roborecyclevip/2026_robo_recycle/3d models/independent_clamp_18mm_v2/generated/preview_DRAFT.png

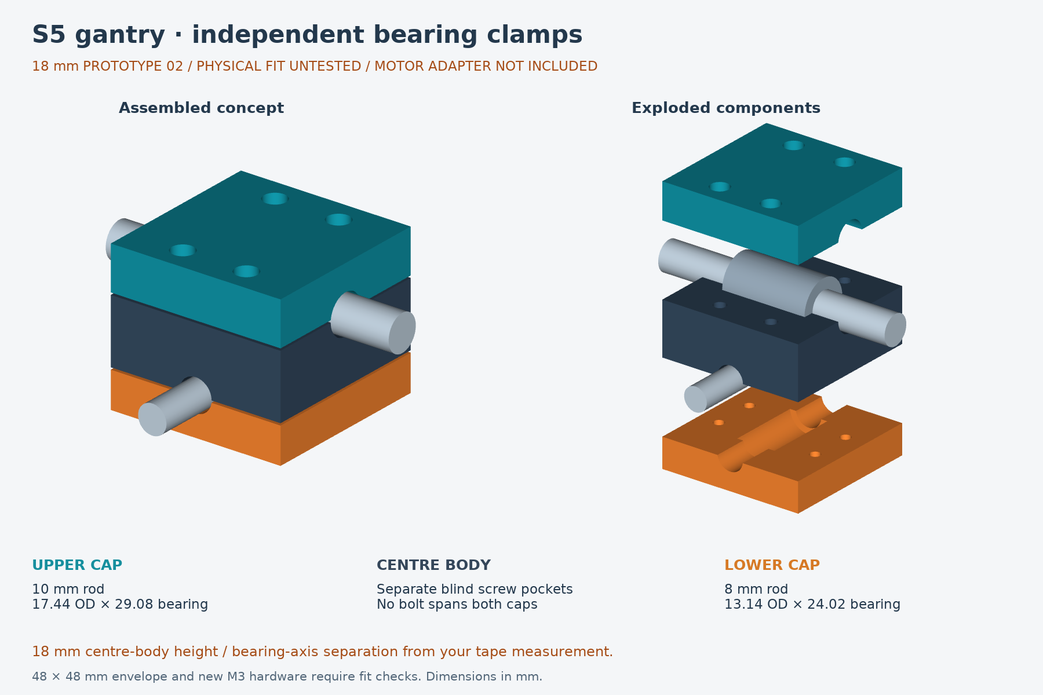
3d models/independent_clamp_18mm_v2/generated/preview_DRAFT.png
