roborecyclevip/2026_robo_recycle/docs/images/system_flowchart.png

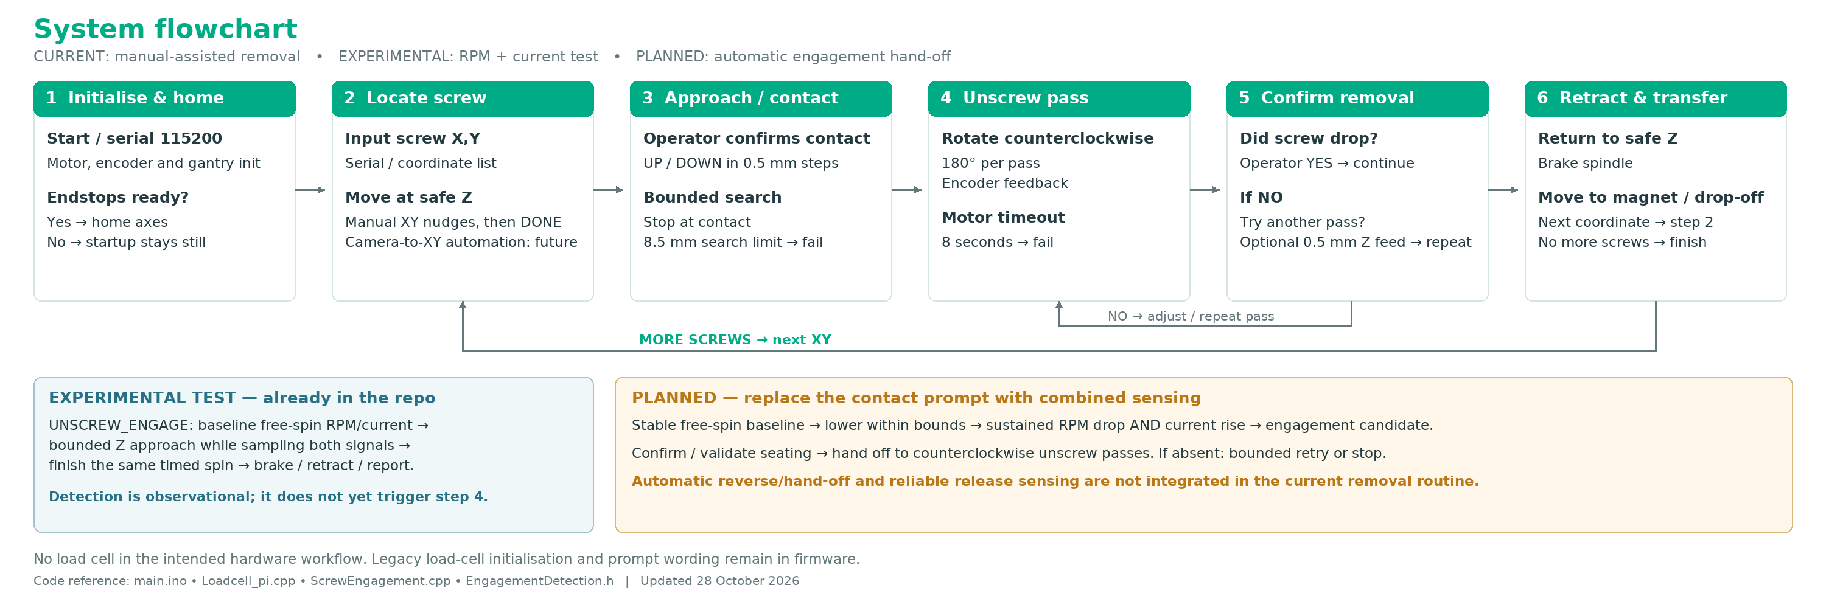
docs/images/system_flowchart.png
