roborecyclevip/2026_robo_recycle/saved_image.jpg

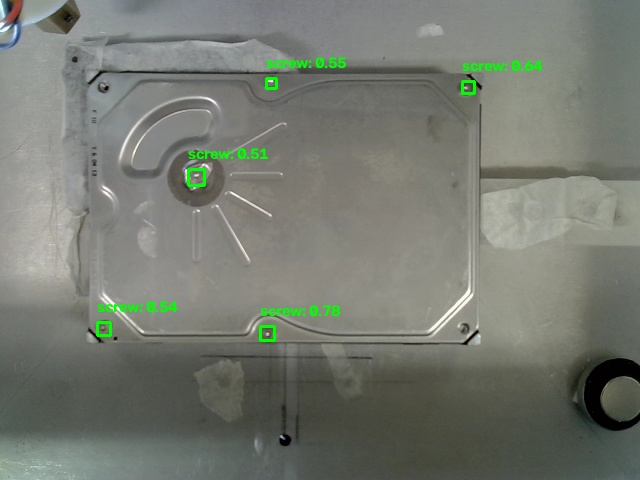
saved_image.jpg
