roborecyclevip/2026_robo_recycle/web_cam_7_oct_photos_of_hdd/my_photo-1.jpg

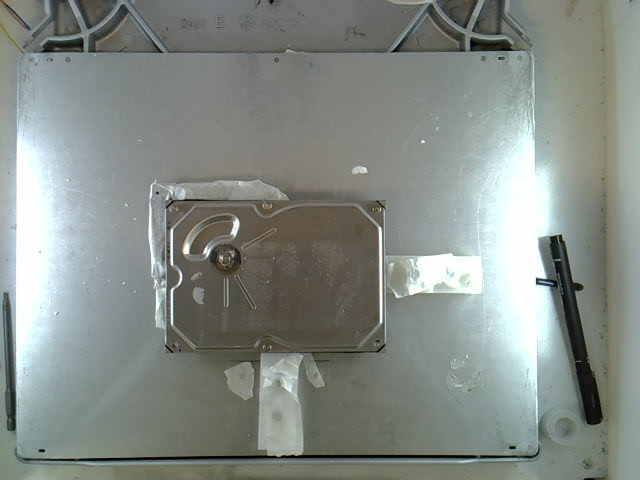
web_cam_7_oct_photos_of_hdd/my_photo-1.jpg
