roborecyclevip/2026_robo_recycle/3d models/independent_clamp_nut_v3/SHOPPING_LIST.md

# Bunnings Campbelltown — shopping list for v3

Checked 22 October 2026. These are Bunnings online listings, NOT confirmed stock at Campbelltown. Select Campbelltown on the product pages or phone before travelling. Prices can differ/change.

| Buy | Product / Bunnings item number | Listed price | Used in model |
|---|---|---:|---|
| 1 pack | [Pinnacle M3 × 15 mm zinc-plated round-head bolts and nuts, 20 pack](https://www.bunnings.com.au/pinnacle-m3-x-15mm-zinc-plated-round-head-bolts-and-nuts-20-pack_p0168388), **0168388** | $4.12 | Eight bolts: four top cap, four lower cap. Matching plain hex nuts are included. |
| 1 pack | [Pinnacle M3 × 20 mm zinc-plated round-head bolts and nuts, 18 pack](https://www.bunnings.com.au/pinnacle-m3-x-20mm-zinc-plated-round-head-bolts-and-nuts-18-pack_p0247264), **0247264** | $1.86 | Four motor-to-foot bolts and matching nuts. Length assumes an accessible 2–10 mm thick mounting flange, nominal 4 mm. |
| 2 packs | [Pinnacle M3 black flat washers, 12 pack](https://www.bunnings.com.au/pinnacle-m3-black-flat-washer-12-pack_p0257725), **0257725** | $1.53 each | Twelve used, twelve spare. Listing gives 3.5 mm hole and 7 mm OD. Put one under every bolt head. |

Listed hardware total: **$9.04**. Nuts are included: no separate nut pack, inserts, soldering iron or thread taps are needed. Check the contents on the packet before purchasing.

## Check in the shop

- M3 metric **0.5 mm pitch** machine bolts, not timber/self-tapping screws, not countersunk heads.
- Ordinary M3 hex nuts, nominal **5.5 mm across flats and 2.4 mm thick**. Do not substitute taller nyloc, flange or cap nuts: they will not fit these pockets. Exact Pinnacle nut envelope is not published on the linked listing; measure/check the purchased nuts with the included coupon before the main print.
- Washers must fit the 8.2 mm counterbores. The design calculation uses 0.5 mm thickness; 0.3–0.8 mm is the checked clamp-stack range. If the purchased washers are thicker, change the stack/recess before assembly rather than losing nut engagement.
- Obtain a small screwdriver/bit that snugly fits the actual supplied bolt heads. Do not assume the original S5 hex driver fits these round-head bolts.

## Useful extras, only if you do not already have them

- **150 mm digital or vernier caliper:** strongly useful for measuring the nut pockets, 18 mm middle section and actual mounting pattern; no brand/stock/price confirmed here.
- Small tweezers or needle-nose pliers to load nuts through the side slots.
- 3.5 mm drill bit for gently clearing printed M3 holes and, only after fit verification, enlarging existing *plastic* M2.5 clearance holes where adequate wall remains. Clamp the removed part; do not drill near installed bearings, rods, motor or wiring. Do not enlarge an original threaded metal hole on assumption.
- Fine file/deburring tool and normal eye protection for drilling/support removal.

Do not buy threadlocker or glue for the printed nut traps. Captive pockets prevent nut rotation during tightening but are not vibration-locking nuts. Inspect witness marks and preload during testing; this prototype is not approved for unattended drill operation.

## Store

[Bunnings Campbelltown](https://www.bunnings.com.au/stores/nsw/campbelltown): corner Blaxland Road and Farrow Road, Campbelltown NSW 2560; **02 4634 6400**. The live store page takes precedence over older listings for a different Campbelltown address. No order or reservation has been placed.
