roborecyclevip/2026_robo_recycle/3d models/independent_clamp_draft_v1/generated/housing_assembly_DRAFT.step

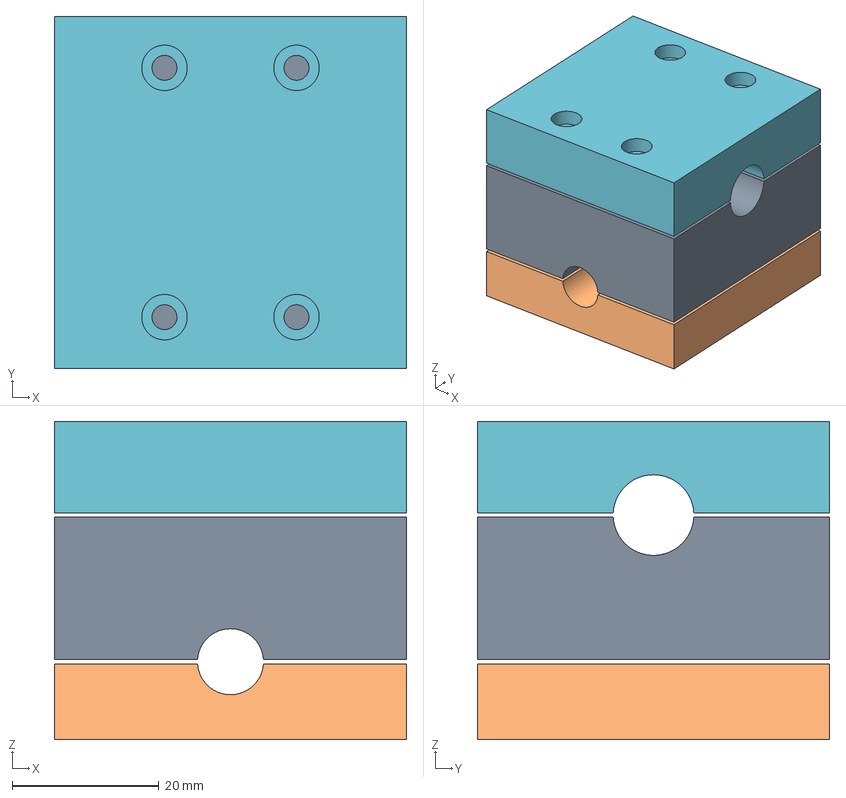
[picture p9: CAD file, 2026-10-22]
3d models/independent_clamp_draft_v1/generated/housing_assembly_DRAFT.step
48.0 x 48.0 x 43.4 mm
centre_body
upper_X_cap
lower_Y_cap
