roborecyclevip/2026_robo_recycle/3d models/independent_clamp_18mm_v2/generated/housing_assembly_DRAFT.step

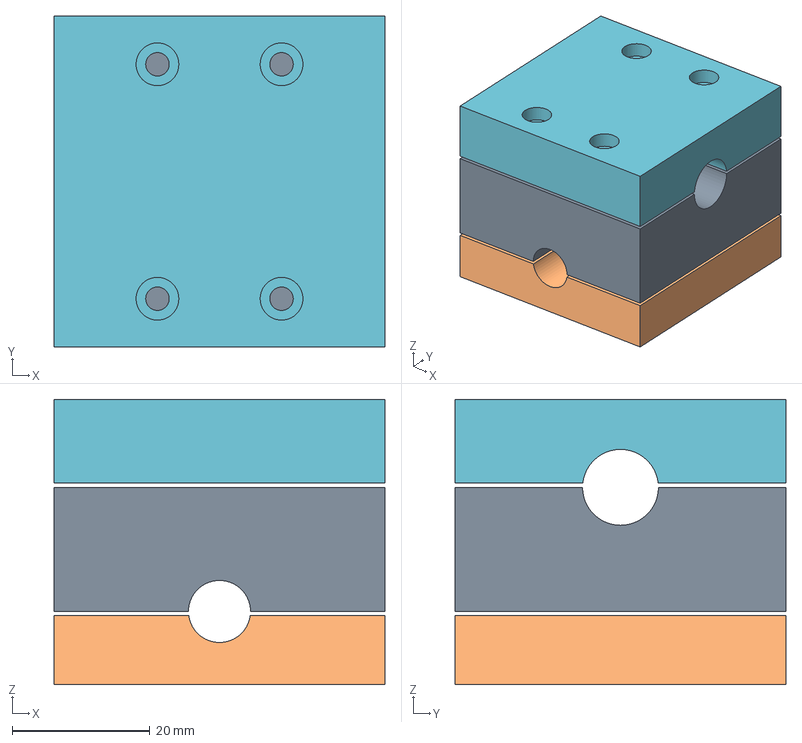
[picture p10: CAD file, 2026-10-22]
3d models/independent_clamp_18mm_v2/generated/housing_assembly_DRAFT.step
48.0 x 48.0 x 41.4 mm
centre_body
upper_X_cap
lower_Y_cap
