roborecyclevip/2026_robo_recycle/3d models/centre_body.stl

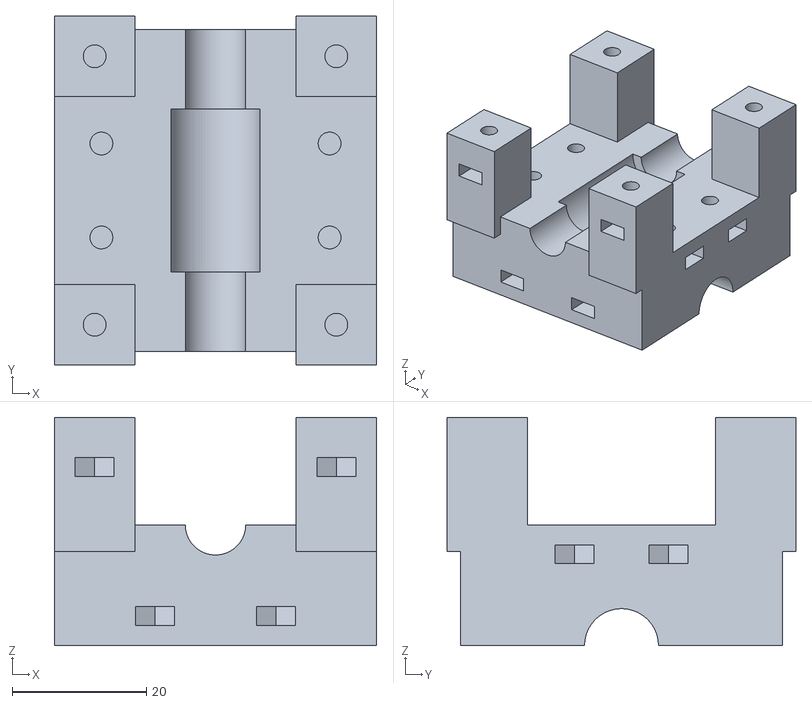
[picture p11: CAD file, 2026-10-22]
3d models/centre_body.stl
48.0 x 52.0 x 34.0
