roborecyclevip/2026_robo_recycle/3d models/independent_clamp_18mm_v2/generated/coupon_upper_plus0.10_DRAFT.stl

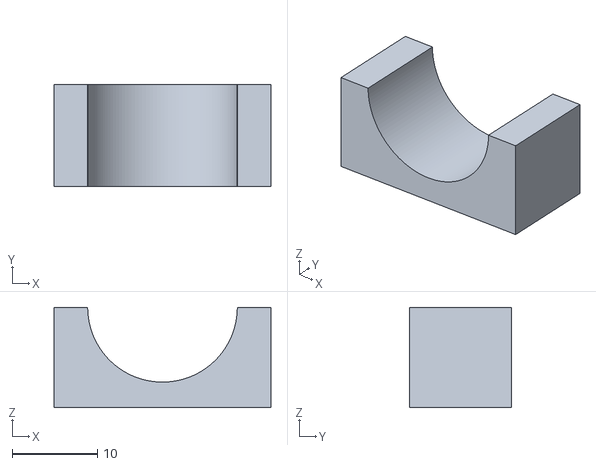
[picture p12: CAD file, 2026-10-22]
3d models/independent_clamp_18mm_v2/generated/coupon_upper_plus0.10_DRAFT.stl
25.4 x 12.0 x 11.8
