roborecyclevip/2026_robo_recycle/3d models/independent_clamp_draft_v1/generated/with_reference_rods_DRAFT.step

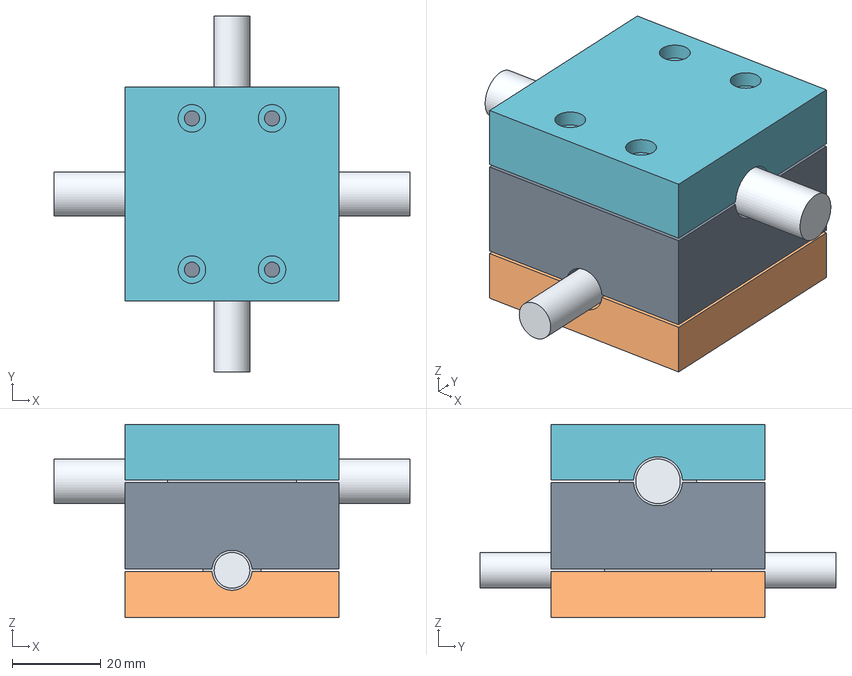
[picture p13: CAD file, 2026-10-22]
3d models/independent_clamp_draft_v1/generated/with_reference_rods_DRAFT.step
80.0 x 80.0 x 43.4 mm
centre_body
upper_X_cap
lower_Y_cap
upper_bearing_reference
lower_bearing_reference
upper_X_rod_reference
lower_Y_rod_reference
