roborecyclevip/2026_robo_recycle/3d models/independent_clamp_18mm_v2/generated/centre_body_DRAFT.step

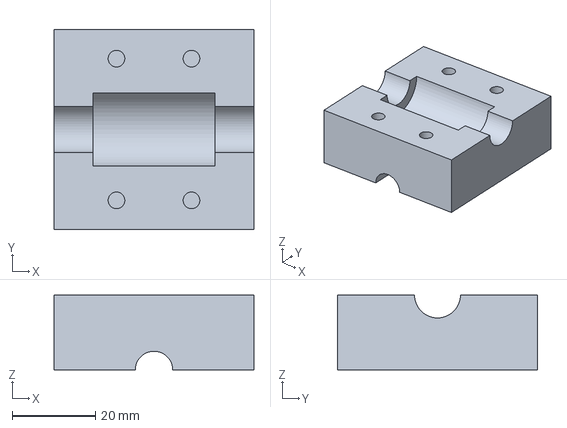
[picture p14: CAD file, 2026-10-22]
3d models/independent_clamp_18mm_v2/generated/centre_body_DRAFT.step
48.0 x 48.0 x 18.0 mm
