roborecyclevip/2026_robo_recycle/3d models/upper_cap.stl

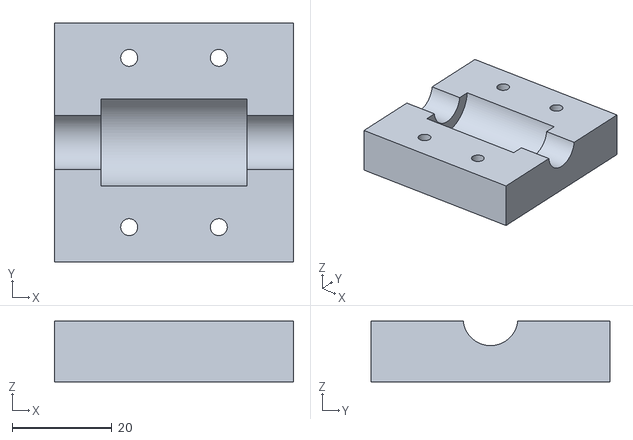
[picture p15: CAD file, 2026-10-22]
3d models/upper_cap.stl
48.0 x 48.0 x 12.2
