roborecyclevip/2026_robo_recycle/3d models/independent_clamp_18mm_v2/generated/with_reference_rods_DRAFT.step

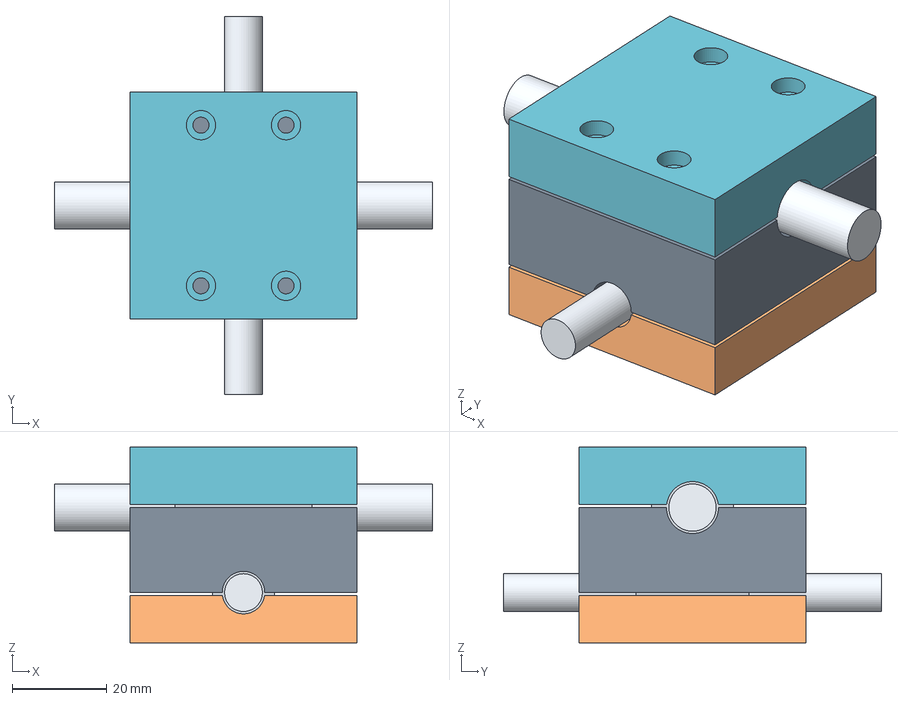
[picture p16: CAD file, 2026-10-22]
3d models/independent_clamp_18mm_v2/generated/with_reference_rods_DRAFT.step
80.0 x 80.0 x 41.4 mm
centre_body
upper_X_cap
lower_Y_cap
upper_bearing_reference
lower_bearing_reference
upper_X_rod_reference
lower_Y_rod_reference
