roborecyclevip/2026_robo_recycle/3d models/independent_clamp_draft_v1/generated/upper_X_cap_DRAFT.step

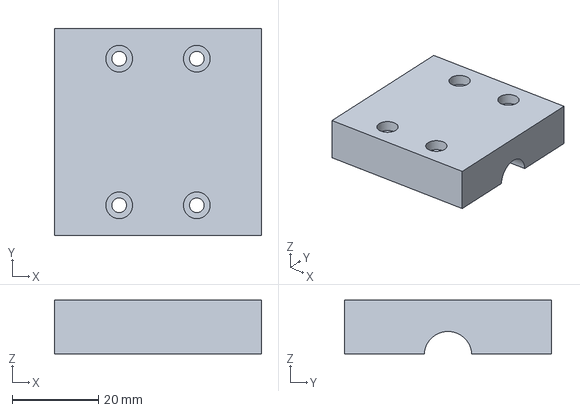
[picture p18: CAD file, 2026-10-22]
3d models/independent_clamp_draft_v1/generated/upper_X_cap_DRAFT.step
48.0 x 48.0 x 12.5 mm
