roborecyclevip/2026_robo_recycle/3d models/independent_clamp_18mm_v2/generated/upper_X_cap_DRAFT.step

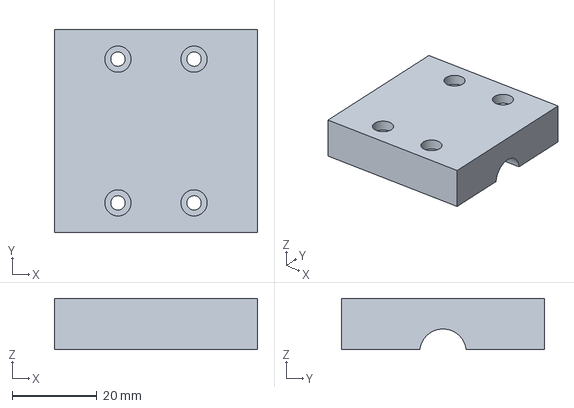
[picture p19: CAD file, 2026-10-22]
3d models/independent_clamp_18mm_v2/generated/upper_X_cap_DRAFT.step
48.0 x 48.0 x 12.2 mm
