roborecyclevip/2026_robo_recycle/3d models/independent_clamp_draft_v1/generated/lower_Y_cap_DRAFT.step

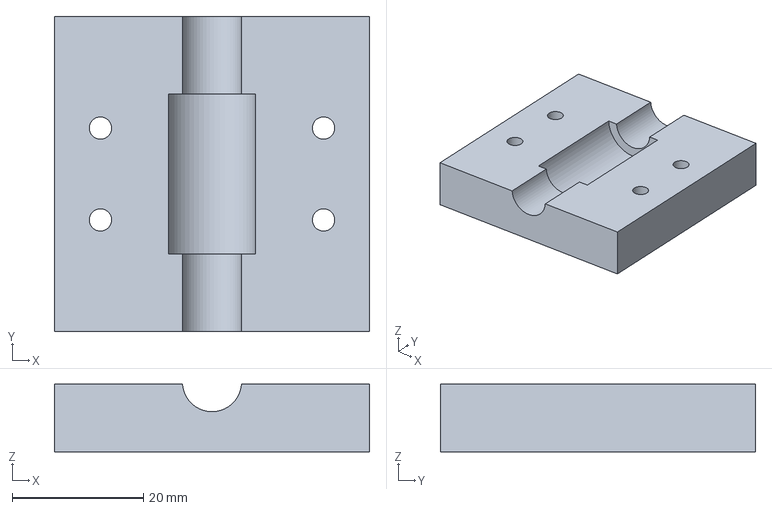
[picture p20: CAD file, 2026-10-22]
3d models/independent_clamp_draft_v1/generated/lower_Y_cap_DRAFT.step
48.0 x 48.0 x 10.3 mm
