roborecyclevip/2026_robo_recycle/3d models/independent_clamp_18mm_v2/generated/lower_Y_cap_DRAFT.step

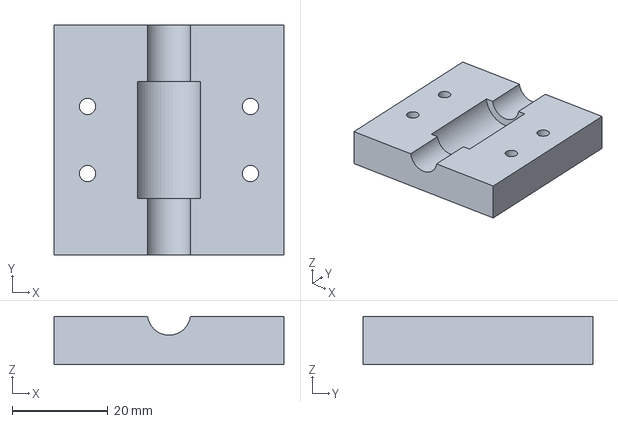
[picture p21: CAD file, 2026-10-22]
3d models/independent_clamp_18mm_v2/generated/lower_Y_cap_DRAFT.step
48.0 x 48.0 x 10.0 mm
