roborecyclevip/2026_robo_recycle/3d models/independent_clamp_draft_v1/generated/centre_body_DRAFT.step

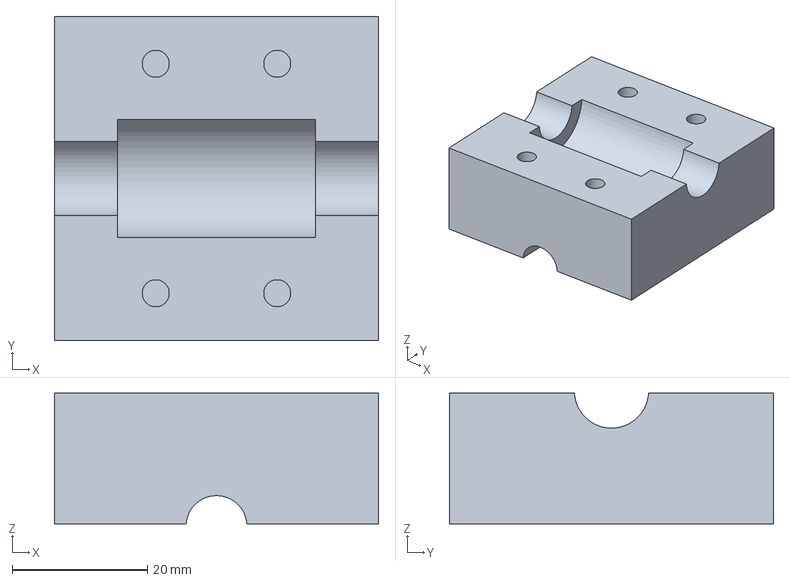
[picture p22: CAD file, 2026-10-22]
3d models/independent_clamp_draft_v1/generated/centre_body_DRAFT.step
48.0 x 48.0 x 19.4 mm
