roborecyclevip/2026_robo_recycle/3d models/independent_clamp_draft_v1/generated/coupon_lower_plus0.20_DRAFT.stl

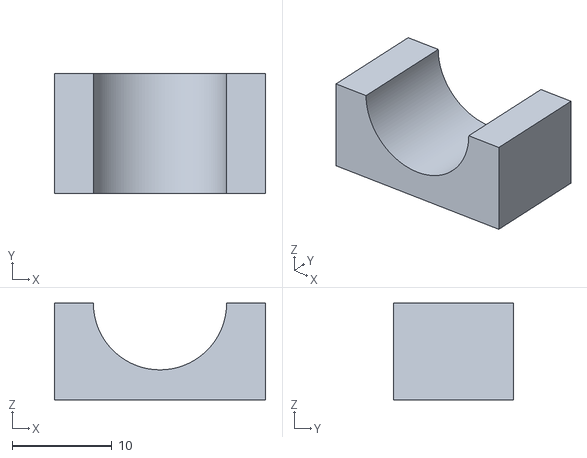
[picture p23: CAD file, 2026-10-22]
3d models/independent_clamp_draft_v1/generated/coupon_lower_plus0.20_DRAFT.stl
21.1 x 12.0 x 9.67
