roborecyclevip/2026_robo_recycle/3d models/independent_clamp_nut_v3/generated/housing_assembly_DRAFT.step

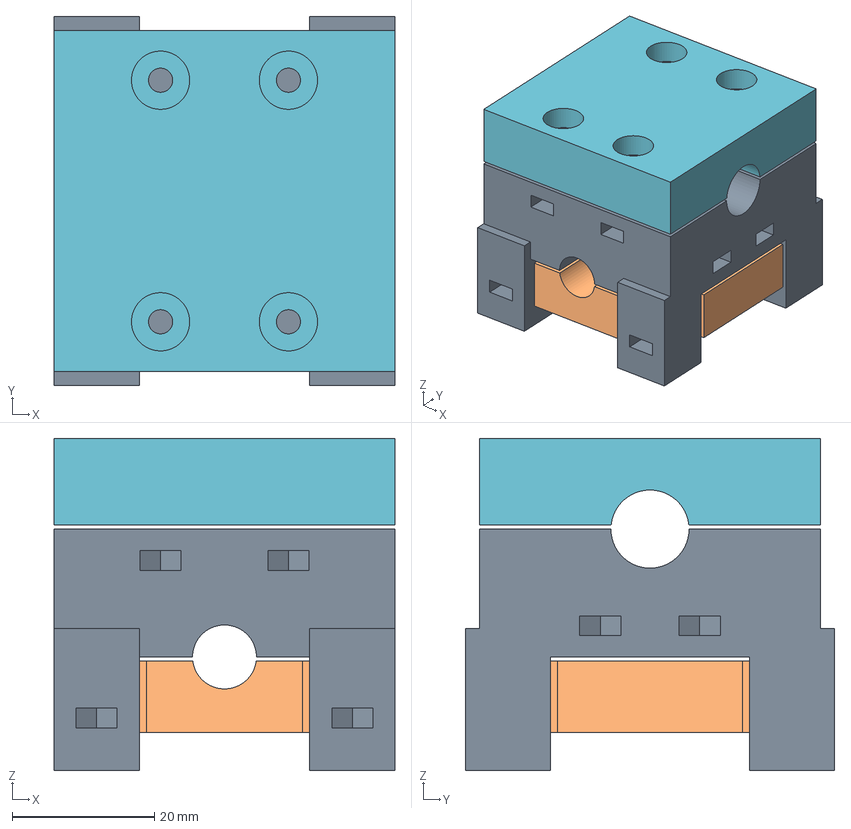
[picture p24: CAD file, 2026-10-22]
3d models/independent_clamp_nut_v3/generated/housing_assembly_DRAFT.step
48.0 x 52.0 x 46.8 mm
centre_body
upper_X_cap
lower_Y_cap
