roborecyclevip/2026_robo_recycle/3d models/independent_clamp_nut_v3/generated/M3_nut_fit_CHECK_FIRST.stl

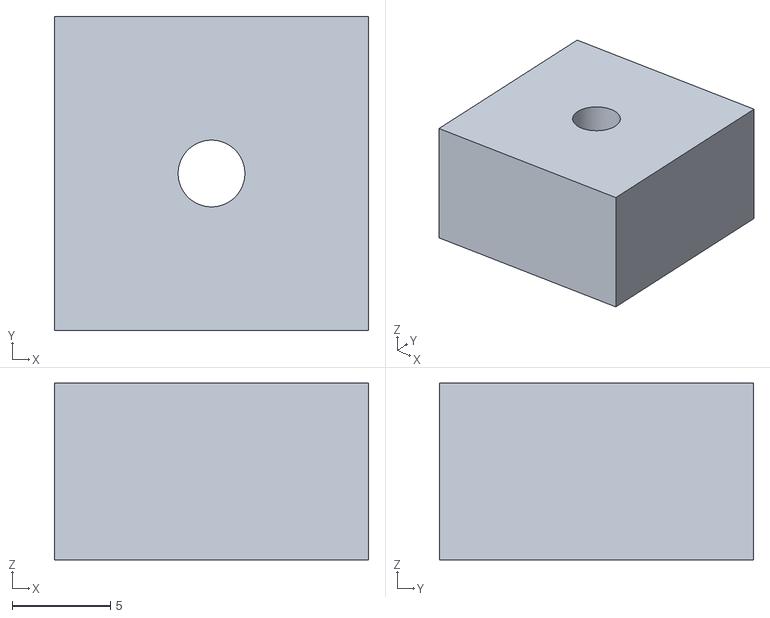
[picture p25: CAD file, 2026-10-22]
3d models/independent_clamp_nut_v3/generated/M3_nut_fit_CHECK_FIRST.stl
16.0 x 16.0 x 9.00
