roborecyclevip/2026_robo_recycle/(list of files, cad)

Other CAD files:
3d models/independent_clamp_nut_v3/generated/coupon_upper_plus0.20_DRAFT.stl
3d models/independent_clamp_18mm_v2/generated/centre_body_DRAFT.stl
3d models/independent_clamp_18mm_v2/generated/lower_Y_cap_DRAFT.stl
3d models/independent_clamp_18mm_v2/generated/upper_X_cap_DRAFT.stl
3d models/independent_clamp_draft_v1/generated/centre_body_DRAFT.stl
3d models/independent_clamp_draft_v1/generated/lower_Y_cap_DRAFT.stl
3d models/independent_clamp_draft_v1/generated/upper_X_cap_DRAFT.stl
3d models/independent_clamp_nut_v3/generated/centre_body_DRAFT.step
3d models/independent_clamp_nut_v3/generated/coupon_lower_plus0.10_DRAFT.stl
3d models/independent_clamp_nut_v3/generated/coupon_upper_plus0.00_DRAFT.stl
3d models/independent_clamp_nut_v3/generated/lower_Y_cap_DRAFT.step
3d models/independent_clamp_nut_v3/generated/lower_Y_cap_DRAFT.stl
3d models/independent_clamp_nut_v3/generated/motor_pattern_CHECK_FIRST.stl
3d models/independent_clamp_nut_v3/generated/upper_X_cap_DRAFT.step
3d models/independent_clamp_nut_v3/generated/with_reference_rods_DRAFT.step
