roborecyclevip/2026_robo_recycle/3d models/independent_clamp_18mm_v2/generated/assembled_scene.png

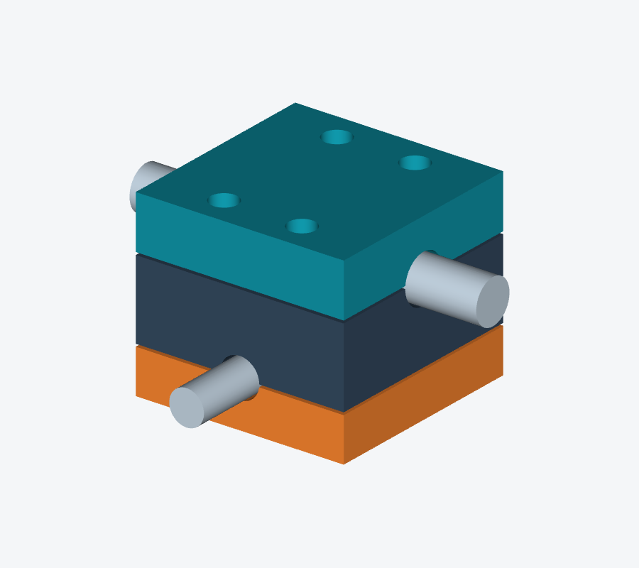
3d models/independent_clamp_18mm_v2/generated/assembled_scene.png
