roborecyclevip/2026_robo_recycle/Test files/with_harddrive.csv

with harddrive
cycle | phase | sample | current_A
1 | unscrewing | 1 | -0.073
1 | unscrewing | 2 | 0.220
1 | unscrewing | 3 | 0.464
1 | unscrewing | 4 | 0.073
1 | unscrewing | 5 | 0.269
1 | unscrewing | 6 | 0.269
1 | unscrewing | 7 | 0.562
1 | unscrewing | 8 | 0.367
1 | unscrewing | 9 | 0.415
1 | unscrewing | 10 | 0.318
1 | unscrewing | 11 | 0.220
1 | unscrewing | 12 | 0.464
1 | unscrewing | 13 | 0.415
1 | unscrewing | 14 | 0.122
1 | unscrewing | 15 | 0.318
1 | unscrewing | 16 | 0.318
1 | unscrewing | 17 | 0.318
1 | unscrewing | 18 | 0.415
1 | unscrewing | 19 | 0.367
1 | unscrewing | 20 | 0.318
1 | unscrewing | 21 | 0.269
1 | unscrewing | 22 | 0.220
1 | unscrewing | 23 | 0.415
1 | unscrewing | 24 | 0.318
1 | unscrewing | 25 | 0.367
1 | unscrewing | 26 | 0.269
1 | unscrewing | 27 | 0.415
1 | unscrewing | 28 | 0.122
1 | unscrewing | 29 | 0.269
1 | unscrewing | 30 | 0.269
1 | unscrewing | 31 | 0.367
1 | unscrewing | 32 | 0.415
1 | unscrewing | 33 | 0.269
1 | unscrewing | 34 | 0.318
1 | unscrewing | 35 | 0.415
1 | unscrewing | 36 | 0.367
1 | unscrewing | 37 | 0.367
1 | unscrewing | 38 | 0.318
1 | unscrewing | 39 | 0.220
1 | unscrewing | 40 | 0.367
1 | unscrewing | 41 | 0.269
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
