roborecyclevip/2026_robo_recycle/System Integration/main/STEPPERmotor.cpp

#include <Stepper.h>
#include <math.h>

#ifndef STEPPERMOTOR_H
#define STEPPERMOTOR_H

#include "MultiStepperLite.h"

// === CONFIG ===
#define STEPS_PER_MM_XY 143.8848920863309352517985612 // 10000 steps / 69.5 <-- Used Python decimal library to calc
#define STEPS_PER_MM_Z 398.7240829346092503987240829     // 10000 steps / 25.08 mm <-- ''

// === X AXIS ===
#define X_STEP_PIN 2
#define X_DIR_PIN 5
#define X_ENDSTOP_PIN 9
#define X_MOTOR_INDEX 0

// === Y AXIS ===
#define Y_STEP_PIN 3
#define Y_DIR_PIN 6
#define Y_ENDSTOP_PIN 10
#define Y_MOTOR_INDEX 1

// === Z AXIS ===
#define Z_STEP_PIN 4
#define Z_DIR_PIN 7
#define Z_ENDSTOP_PIN 11
#define Z_MOTOR_INDEX 2

// Step intervals in microseconds (derived from max speed)
#define STEP_INTERVAL_XY 10    // 100,000 steps/s = 10 µs/step
#define STEP_INTERVAL_Z 33     // 30,000 steps/s ≈ 33 µs/step
#define HOMING_STEP_INTERVAL 5000  // 200 steps/s = 5,000 µs/step
#define HOMING_TIMEOUT_MS 20000

// Global stepper instance and position variables
MultiStepperLite steppers(3); // Initialize with 3 motors (X, Y, Z)
float currentX = 0.0; // Current position in mm
float currentY = 0.0;
float currentZ = 0.0;
bool cooperativeZActive = false;
long cooperativeZSteps = 0;
float cooperativeZStart = 0.0;
int cooperativeZDirection = 1;

void setDirection(int dirPin, bool forward) {
  digitalWrite(dirPin, forward ? HIGH : LOW);
}

// homeAxis
void homeAxis(uint8_t motorIndex, int dirPin, int endstopPin, const char* axisName, bool reverse) {
  Serial.print("Homing ");
  Serial.println(axisName);

  int initialState = digitalRead(endstopPin);
  Serial.print(axisName);
  Serial.print(" endstop initial state: ");
  Serial.println(initialState == HIGH ? "HIGH" : "LOW");

  if (digitalRead(endstopPin) == LOW) {
    return;
  }

  pinMode(dirPin, OUTPUT);
  setDirection(dirPin, reverse ? true : false); // Z homes in positive direction, X/Y negative
  steppers.start_continuous(motorIndex, 200);

  unsigned long startMs = millis();
  while (digitalRead(endstopPin) != LOW) {
    steppers.do_tasks();

    if (millis() - startMs > HOMING_TIMEOUT_MS) {
      steppers.stop(motorIndex);
      while (!steppers.is_finished(motorIndex)) {
        steppers.do_tasks();
      }

      Serial.print("ERROR: ");
      Serial.print(axisName);
      Serial.println(" homing timeout. Check endstop state/direction.");
      return;
    }
  }

  steppers.stop(motorIndex);
  while (!steppers.is_finished(motorIndex)) {
    steppers.do_tasks(); // Ensure graceful stop (step pin LOW)
  }

  // Reset position to 0
  if (motorIndex == X_MOTOR_INDEX) currentX = 0.0;
  if (motorIndex == Y_MOTOR_INDEX) currentY = 0.0;
  if (motorIndex == Z_MOTOR_INDEX) currentZ = 0.0;

  Serial.print("Homed ");
  Serial.println(axisName);
}

void STEPPERmotor_Init() {
  // Initialize endstop pins
  pinMode(X_ENDSTOP_PIN, INPUT_PULLUP);
  pinMode(Y_ENDSTOP_PIN, INPUT_PULLUP);
  pinMode(Z_ENDSTOP_PIN, INPUT_PULLUP);

  // Initialize steppers
  steppers.init_stepper(X_MOTOR_INDEX, X_STEP_PIN);
  steppers.init_stepper(Y_MOTOR_INDEX, Y_STEP_PIN);
  steppers.init_stepper(Z_MOTOR_INDEX, Z_STEP_PIN);

  // Set step intervals
  steppers.set_step_interval(X_MOTOR_INDEX, STEP_INTERVAL_XY);
  steppers.set_step_interval(Y_MOTOR_INDEX, STEP_INTERVAL_XY);
  steppers.set_step_interval(Z_MOTOR_INDEX, STEP_INTERVAL_Z);

  // Initialize direction pins
  pinMode(X_DIR_PIN, OUTPUT);
  pinMode(Y_DIR_PIN, OUTPUT);
  pinMode(Z_DIR_PIN, OUTPUT);

  // Enable time autocorrect
#if TIME_AUTOCORRECT_SUPPORT
  steppers.set_autocorrect(true);
  steppers.set_min_step_interval(X_MOTOR_INDEX, STEP_INTERVAL_XY);
  steppers.set_min_step_interval(Y_MOTOR_INDEX, STEP_INTERVAL_XY);
  steppers.set_min_step_interval(Z_MOTOR_INDEX, STEP_INTERVAL_Z);
#endif

  // Initialize positions
  currentX = 0.0;
  currentY = 0.0;
  currentZ = 0.0;
}

bool Stepper_EndstopsReady() {
  // INPUT_PULLUP means a released switch should read HIGH and a pressed
  // (or shorted) switch should read LOW.
  const int xState = digitalRead(X_ENDSTOP_PIN);
  const int yState = digitalRead(Y_ENDSTOP_PIN);
  const int zState = digitalRead(Z_ENDSTOP_PIN);

  Serial.println("Initial end-stop check:");
  Serial.print("  X: ");
  Serial.println(xState == HIGH ? "RELEASED" : "PRESSED");
  Serial.print("  Y: ");
  Serial.println(yState == HIGH ? "RELEASED" : "PRESSED");
  Serial.print("  Z: ");
  Serial.println(zState == HIGH ? "RELEASED" : "PRESSED");

  // Bare-minimum startup guard: do not start homing if any switch is
  // already active. This avoids moving when a switch is stuck or shorted.
  return xState == HIGH && yState == HIGH && zState == HIGH;
}

void Stepper_HomeX() {
  homeAxis(X_MOTOR_INDEX, X_DIR_PIN, X_ENDSTOP_PIN, "X", false);
}

void Stepper_HomeY() {
  homeAxis(Y_MOTOR_INDEX, Y_DIR_PIN, Y_ENDSTOP_PIN, "Y", false);
}

void Stepper_HomeZ() {
  homeAxis(Z_MOTOR_INDEX, Z_DIR_PIN, Z_ENDSTOP_PIN, "Z", true);
}

void Stepper_HomeAll() {
  Stepper_HomeZ();
  Stepper_HomeX();
  Stepper_HomeY();
}

void Stepper_MoveTo(float x_mm, float y_mm, float z_mm) {
  // Convert coordinates to steps
  long x_steps = (long)((x_mm - currentX) * STEPS_PER_MM_XY);
  long y_steps = (long)((y_mm - currentY) * STEPS_PER_MM_XY);
  long z_steps = (long)((z_mm - currentZ) * STEPS_PER_MM_Z);

  // Set direction based on step sign (negative steps = reverse)
  setDirection(X_DIR_PIN, x_steps >= 0); // AccelStepper used -x_steps, so reverse if positive
  setDirection(Y_DIR_PIN, y_steps >= 0); // AccelStepper used -y_steps
  setDirection(Z_DIR_PIN, z_steps <= 0); // Z direction matches steps

  // Start motors with absolute step counts
  // steppers.start_finite(1, 1000, 2500);
  // steppers.start_finite(2, 1000, 2500);
  steppers.start_finite(X_MOTOR_INDEX, 200, abs(x_steps));
  steppers.start_finite(Y_MOTOR_INDEX, 200, abs(y_steps));
  steppers.start_finite(Z_MOTOR_INDEX, 200, abs(z_steps));

  int count = 0;
  // Poll until all motors are finished
  while (!steppers.is_finished(X_MOTOR_INDEX) || 
    !steppers.is_finished(Y_MOTOR_INDEX) || 
    !steppers.is_finished(Z_MOTOR_INDEX)) {
      // if (count % 50000 == 0) {
      //   Serial.println(Loadcell_Read());
      // }


    steppers.do_tasks();
  }

  // Update current positions
  currentX = x_mm;
  currentY = y_mm;
  currentZ = z_mm;
}

bool Stepper_Pulse(char axis, int direction) {
  if (direction == 0) {
    return false;
  }

  const int logicalDirection = direction > 0 ? 1 : -1;
  uint8_t motorIndex;
  int dirPin;
  float *currentPosition;
  float stepsPerMm;
  bool directionPinHigh;

  switch (axis) {
    case 'X':
      motorIndex = X_MOTOR_INDEX;
      dirPin = X_DIR_PIN;
      currentPosition = &currentX;
      stepsPerMm = STEPS_PER_MM_XY;
      directionPinHigh = logicalDirection > 0;
      break;
    case 'Y':
      motorIndex = Y_MOTOR_INDEX;
      dirPin = Y_DIR_PIN;
      currentPosition = &currentY;
      stepsPerMm = STEPS_PER_MM_XY;
      directionPinHigh = logicalDirection > 0;
      break;
    case 'Z':
      motorIndex = Z_MOTOR_INDEX;
      dirPin = Z_DIR_PIN;
      currentPosition = &currentZ;
      stepsPerMm = STEPS_PER_MM_Z;
      directionPinHigh = logicalDirection < 0;
      break;
    default:
      return false;
  }

  setDirection(dirPin, directionPinHigh);
  steppers.start_finite(motorIndex, 200, 1);
  while (!steppers.is_finished(motorIndex)) {
    steppers.do_tasks();
  }

  *currentPosition += logicalDirection / stepsPerMm;
  return true;
}

void Stepper_GetPosition(float &x_mm, float &y_mm, float &z_mm) {
  x_mm = currentX;
  y_mm = currentY;
  z_mm = currentZ;
}

bool Stepper_StartZMove(float z_mm) {
  if (cooperativeZActive || !isfinite(z_mm)) return false;

  cooperativeZStart = currentZ;
  cooperativeZDirection = z_mm >= currentZ ? 1 : -1;
  // Round toward the start so step quantization cannot travel beyond the limit.
  cooperativeZSteps = (long)(fabs(z_mm - currentZ) * STEPS_PER_MM_Z);
  if (cooperativeZSteps == 0) return true;
  setDirection(Z_DIR_PIN, cooperativeZDirection < 0);
  cooperativeZActive = steppers.start_finite(Z_MOTOR_INDEX, 200, cooperativeZSteps);
  return cooperativeZActive;
}

void Stepper_ServiceZMove() {
  if (!cooperativeZActive) return;
  steppers.do_tasks();
  const long completed = cooperativeZSteps - steppers.get_remaining_steps(Z_MOTOR_INDEX);
  // Use emitted steps, rather than elapsed time, so a stopped move retains its position.
  currentZ = cooperativeZStart + cooperativeZDirection * completed / STEPS_PER_MM_Z;
  if (steppers.is_finished(Z_MOTOR_INDEX)) cooperativeZActive = false;
}

bool Stepper_ZMoveBusy() { return cooperativeZActive; }

void Stepper_StopZMove() {
  if (!cooperativeZActive) return;
  Stepper_ServiceZMove(); // Save position BEFORE stop() discards remaining steps.
  steppers.stop(Z_MOTOR_INDEX);
  while (!steppers.is_finished(Z_MOTOR_INDEX)) steppers.do_tasks();
  cooperativeZActive = false;
}

#endif
