roborecyclevip/2026_robo_recycle/System Integration/main/DCmotor.h

#ifndef DCMOTOR_H
#define DCMOTOR_H

#include <Arduino.h>

/**
 * @brief Initialize the DC motor driver pins.
 */
void DCmotor_Init();

/**
 * @brief Drive motor forward at a given speed.
 * @param speed PWM value (0–255).
 */
void Motor_Forward(int speed);

/**
 * @brief Drive motor backward at a given speed.
 * @param speed PWM value (0–255).
 */
void Motor_Backward(int speed);

/**
 * @brief Stop motor (brake).
 */
void Motor_Brake();

/**
 * Rotate the motor a precise number of degrees using the encoder.
 *
 * @param degrees     Positive = forward, negative = backward
 * @param speed       PWM value 0-255
 * @param timeoutMs   0 = no timeout
 * @return true if target reached, false on timeout
 */
bool Motor_RotateDegrees(float degrees, int speed = 200,
                         unsigned long timeoutMs = 0);

#endif
