roborecyclevip/2026_robo_recycle/Test files/ForceTesting.ino

#include "HX711.h"
#include "SerialConfig.h"

// HX711.DOUT	- pin #A1
// HX711.PD_SCK	- pin #A0

HX711 force(A1, A0);		// parameter "gain" is ommited; the default value 128 is used by the library

void setup() {
  Serial.begin(SERIAL_BAUD_RATE);
  Serial.println("Force Testing");

  Serial.println("Before setting up the scale:");
  Serial.print("read: \t\t");
  Serial.println(force.read());   // print a raw reading from the sensor

  Serial.print("read average: \t\t");
  Serial.println(force.read_average(20));   // print the average of 20 readings from the sensor

  Serial.print("get value: \t\t");
  Serial.println(force.get_value(5));   // print the average of 5 readings from the sensor minus the tare weight (not set yet)

  Serial.print("get units: \t\t");
  Serial.println(force.get_units(5), 1);   // print the average of 5 readings from the sensor minus tare weight (not set) divided 
						                               // by the SCALE parameter (not set yet)  

  force.set_scale(2280.f);                      // this value is obtained by calibrating the scale with known weights; equal to above reading/known weight
  force.tare();   // reset the scale to 0

  Serial.println("After setting up the scale:");

  Serial.print("read: \t\t");
  Serial.println(force.read());   // print a raw reading from the sensor

  Serial.print("read average: \t\t");
  Serial.println(force.read_average(20));   // print the average of 20 readings from the ADC

  Serial.print("get value: \t\t");
  Serial.println(force.get_value(5));   // print the average of 5 readings from the ADC minus the tare weight, set with tare()

  Serial.print("get units: \t\t");
  Serial.println(force.get_units(5), 1);   // print the average of 5 readings from the ADC minus tare weight, divided 
						                               // by the SCALE parameter set with set_scale

  Serial.println("Readings:");
}

void loop() {
  Serial.print("one reading:\t");
  Serial.print(force.get_units(), 1);
  Serial.print("\t| average:\t");
  Serial.println(force.get_units(10), 1);

  force.power_down();   // put the ADC in sleep mode
  delay(5000);
  force.power_up();
}
