roborecyclevip/2026_robo_recycle/(commit log)

2026-04-18 adding my current plans
2026-04-20 made Pi version for the arduino to ask the Pi to know what to do
2026-04-20 added manual control for drill movement when prompted
2026-07-01 saving tests
    [free_spinning.csv]
2026-07-09 saving stuff
    [free_spinning.csv]
2026-08-04 added changes to pulse cuont and endstop chceks
2026-09-11 changed mapping for endstops, which fixed bug with x y and z stops, added a line for debugging and needto update microstepping
    [with_harddrive.csv]
2026-09-22 uploaded screw finding code
2026-09-22 fixed minor bugs in script
    [find_screws.py]
2026-09-22 Updated z axis constant
2026-09-22 added example coordinates.csv file
    [coordinates.csv]
2026-09-29 added find screws command but probs declared it wrong
2026-10-06 Integrating everything together, currently having issues with hidden errors, so if camera is disconnected we don't see the error clearly, and moved scripts to root directory to make life easy
    [DCmotor.cpp, find_screws.py, main.ino]
2026-10-06 saving pictures from webcam
    [coordinates.csv]
2026-10-22 Add S5 independent clamp CAD prototypes and Bunnings shopping guide
2026-10-22 Simplify 3D models to print STLs and concise README
2026-10-22 Restore clamp assembly diagram in simple print guide
2026-10-23 Current and RPM smoothing average curve for screw detection code added, with other misc. changes
2026-10-23 REVIEW: Add experimental screw engagement detection and coordinated Z motion
2026-10-27 Update system flowchart for manual cycle and planned RPM-current engagement
2026-11-03 docs: document Ultimaker S5 touchscreen setup on Raspberry Pi 4
2026-11-10 Changes to new system post cmarea adjsutment and screw dial in with new chuck
